Charlie5DH/Flip-Disc-Display/Documentation/Diagrama de flujo.png

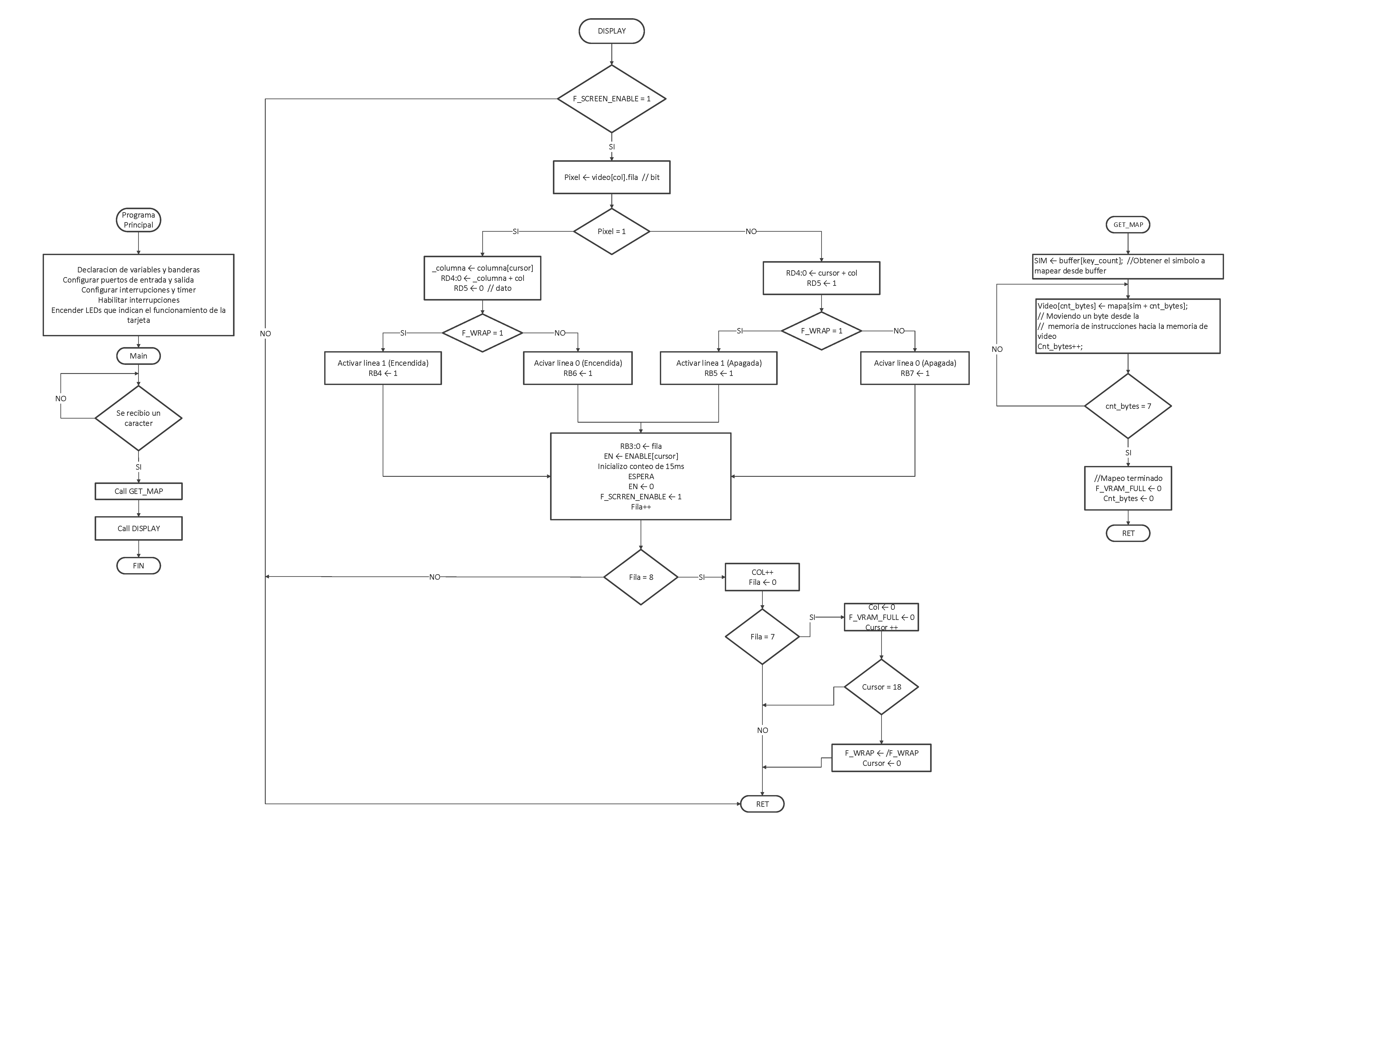
Documentation/Diagrama de flujo.png
