Charlie5DH/Flip-Disc-Display/Documentation/unidad de procesamiento.pdf

# UNIDAD DE PROCESAMIENTO

X1

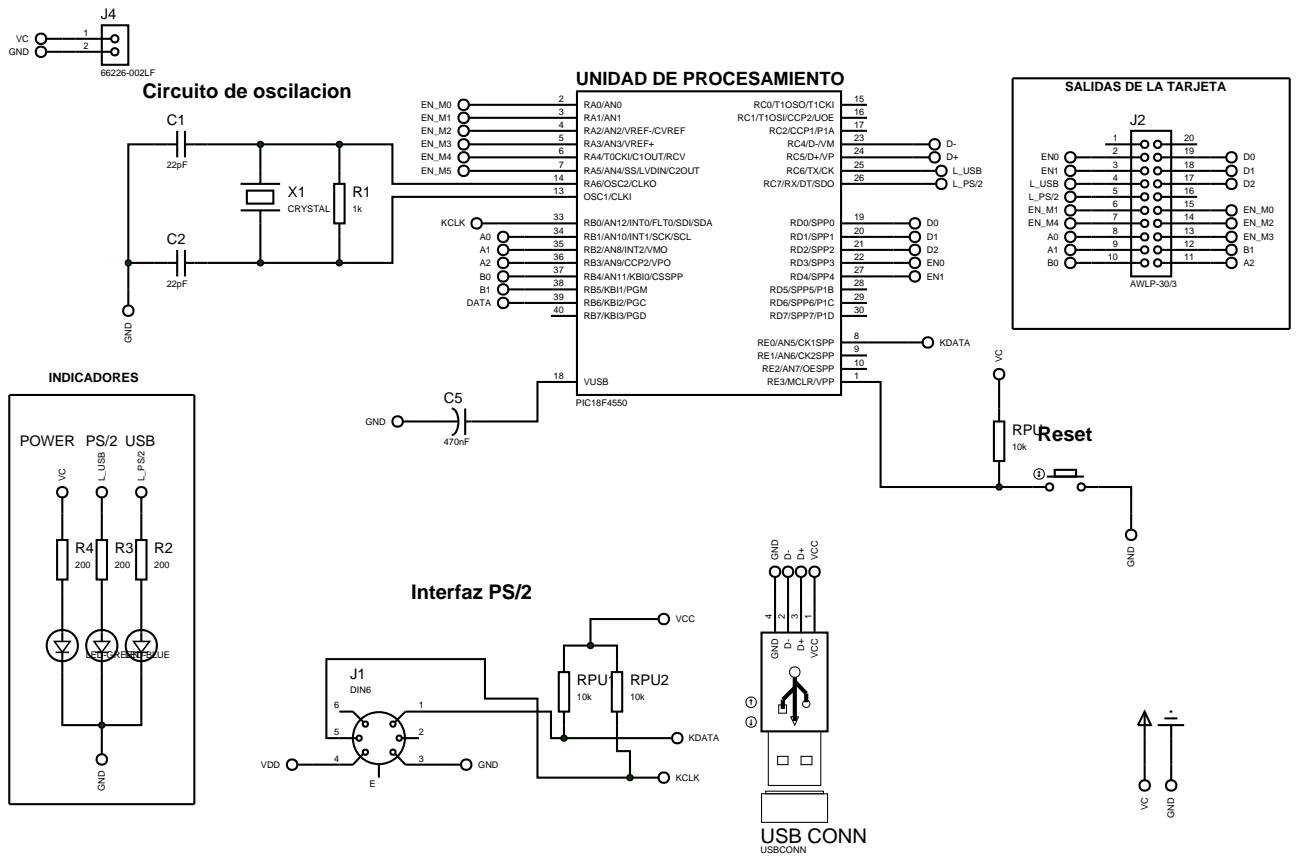
[picture p18: page 1]

SALIDAS DE LA TARJETA

USB CONN USBCONN GND D⁻ D⁺VCC
