Charlie5DH/Flip-Disc-Display/Simulation/simulacion.pdf

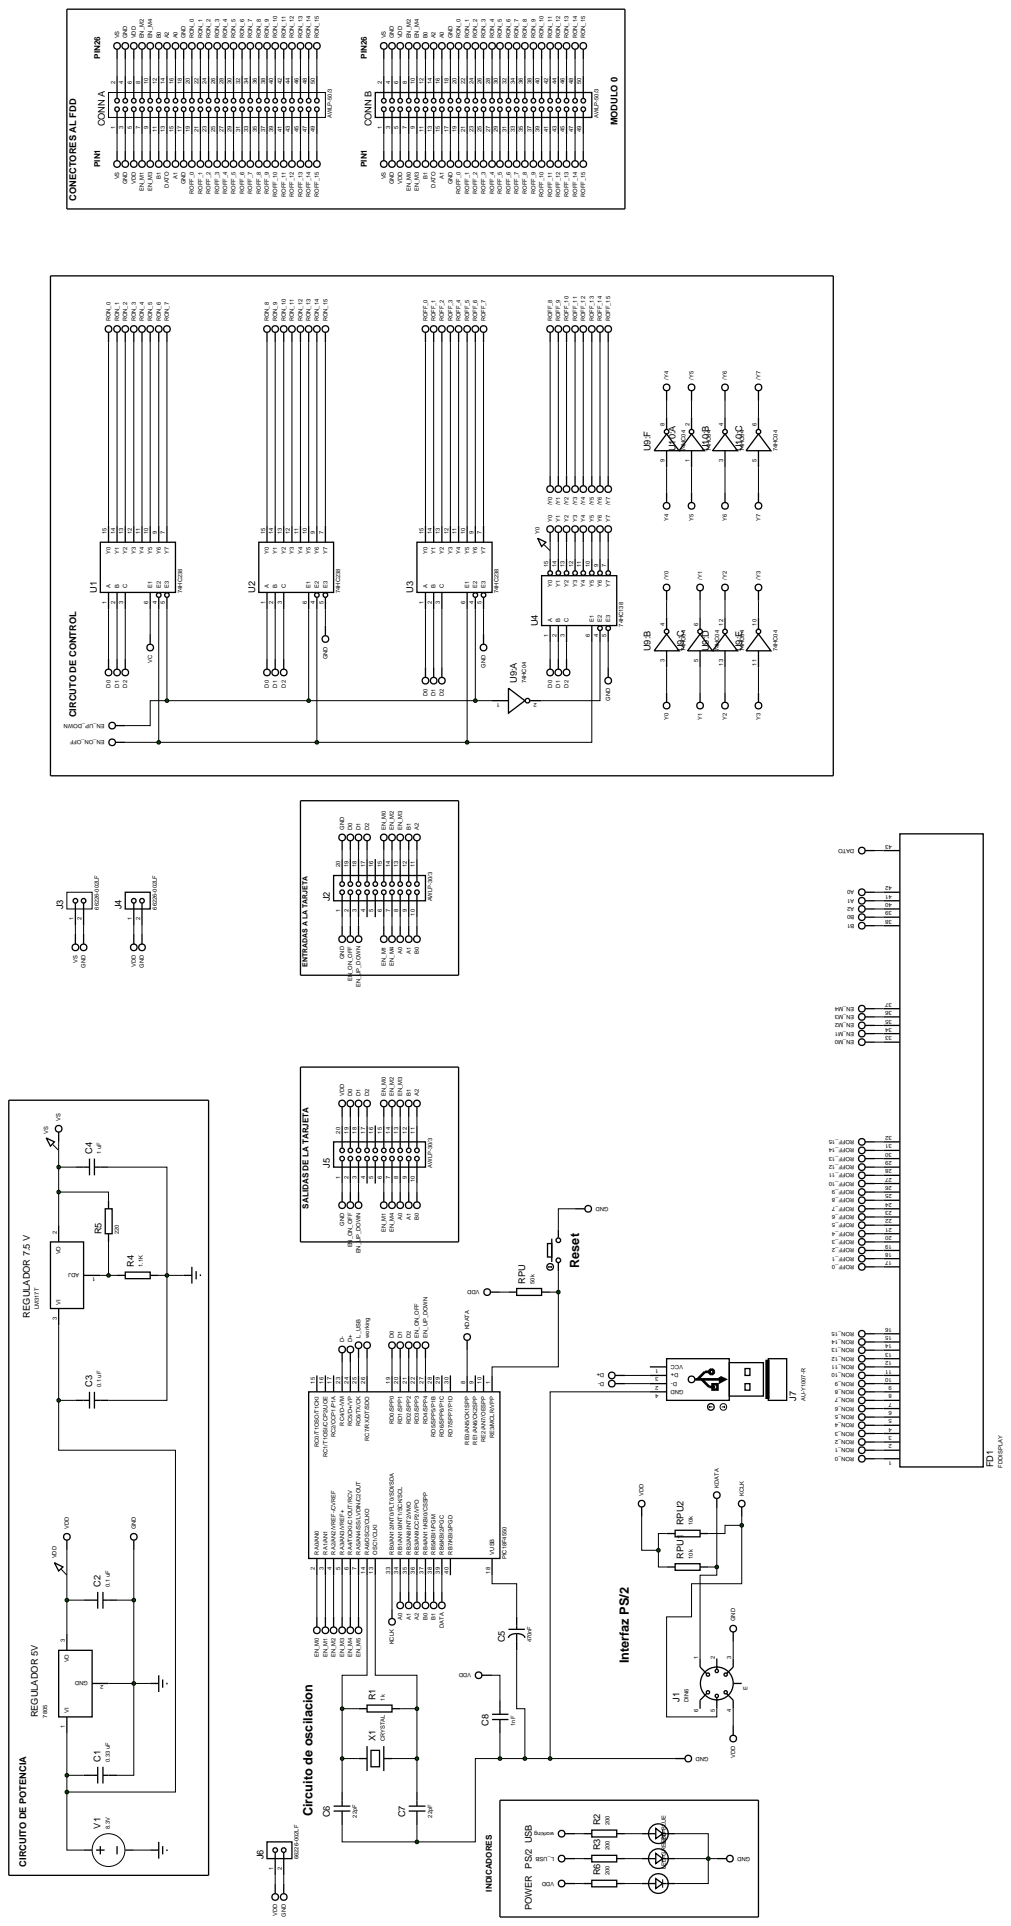
[picture p19: page 1]

CONECTORES AL FDD CIRCUTO DE CONTROL

GND GND VDD GND

SALIDAS DE LA TARJETA
