Charlie5DH/Flip-Disc-Display/Documentation/Diagrama de flujo.pdf

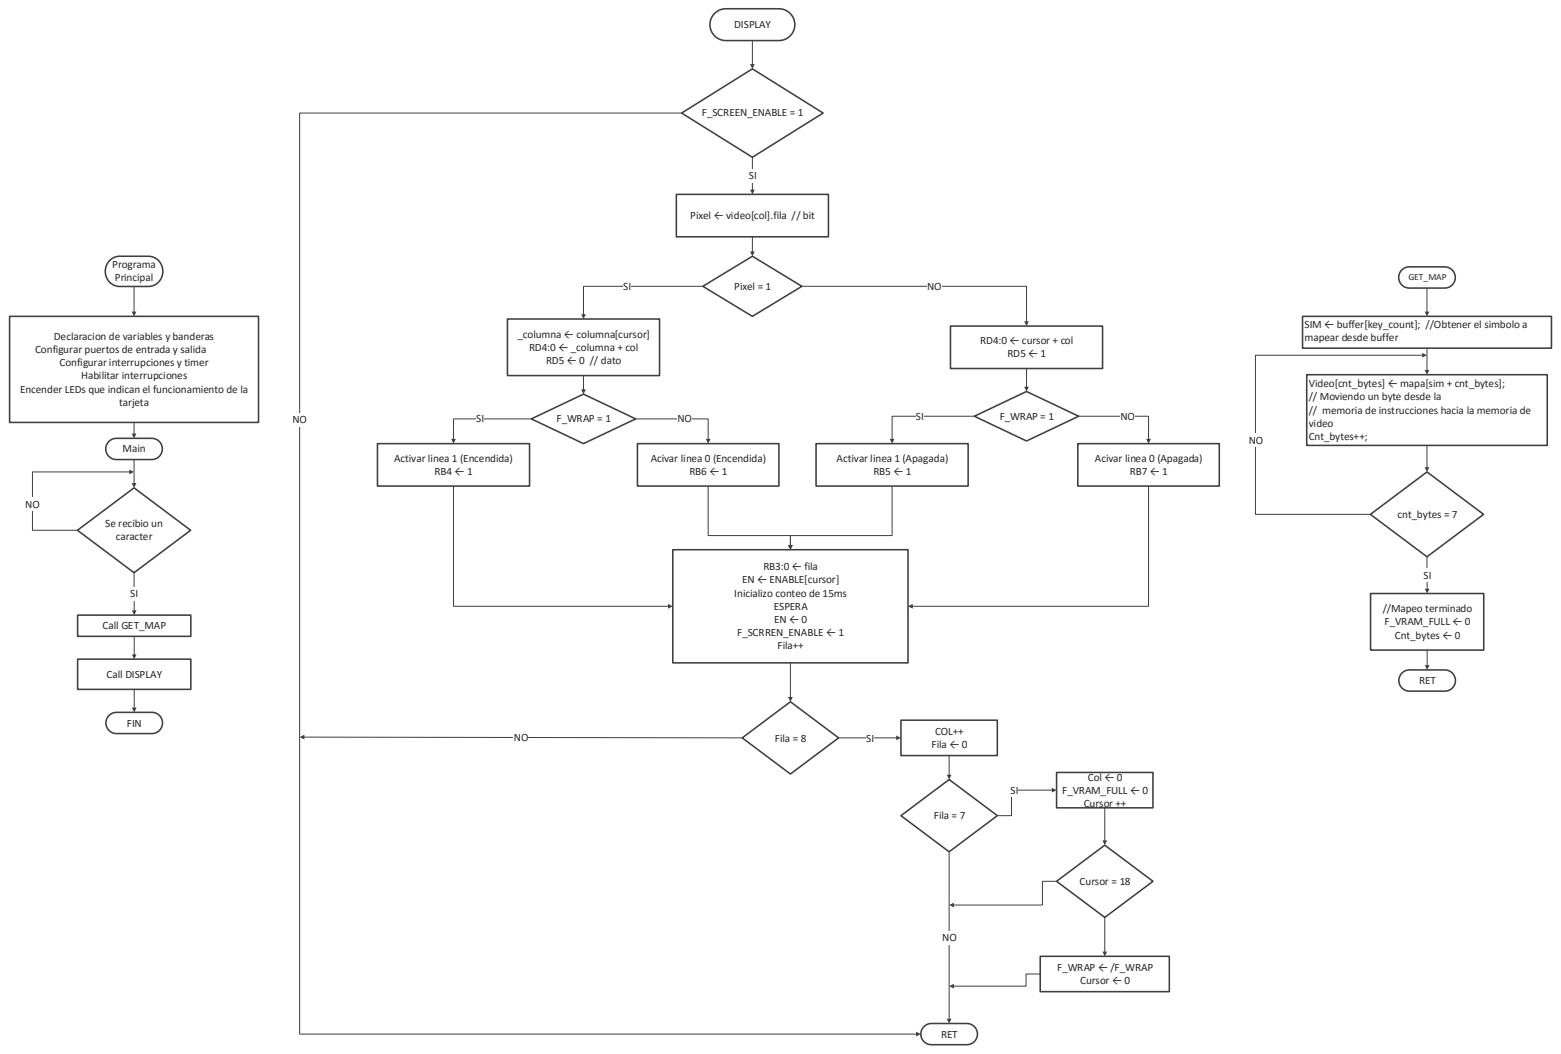
[picture p20: page 1]
GET_MAP; cnt_bytes = 7; SIM; buffer[key_count]; //Obtener el simbolo a; //Mapeo terminado F_VRAM_FULL Cnt_bytes; RET; DISPLAY; F_SCREEN_ENABLE = 1; Pixel; video[col].fila // bit; Pixel = 1; _columna; columna[cursor]; _columna + col; dato; cursor + col; F_WRAP = 1; fila; ENABLE[cursor]; ESPERA EN F_SCRREN_ENABLE Fila++; Fila = 8; COL++ Fila; Fila = 7; Col F_VRAM_FULL Cursor ++; Cursor = 18; F_WRAP; /F_WRAP; Cursor; Programa Principal; tarjeta; Call GET_MAP; FIN; Main; Call DISPLAY

mapear desde buffer

Declaracion de variables y banderas
Configurar puertos de entrada y salida
Configurar interrupciones y timer
Habilitar interrupciones

Video[cnt_bytes] mapa[sim + cnt_bytes]; // Moviendo un byte desde la // memoria de instrucciones hacia la memoria de video Cnt_bytes++;

Encender LEDs que indican el funcionamiento de la

Activar linea 1 (Encendida)

Acivar linea 0 (Encendida)

Activar linea 1 (Apagada)

Acivar linea 0 (Apagada)

Se recibio un
caracter

Inicializo conteo de 15ms
