Charlie5DH/Flip-Disc-Display/Documentation/PCB_micro.pdf

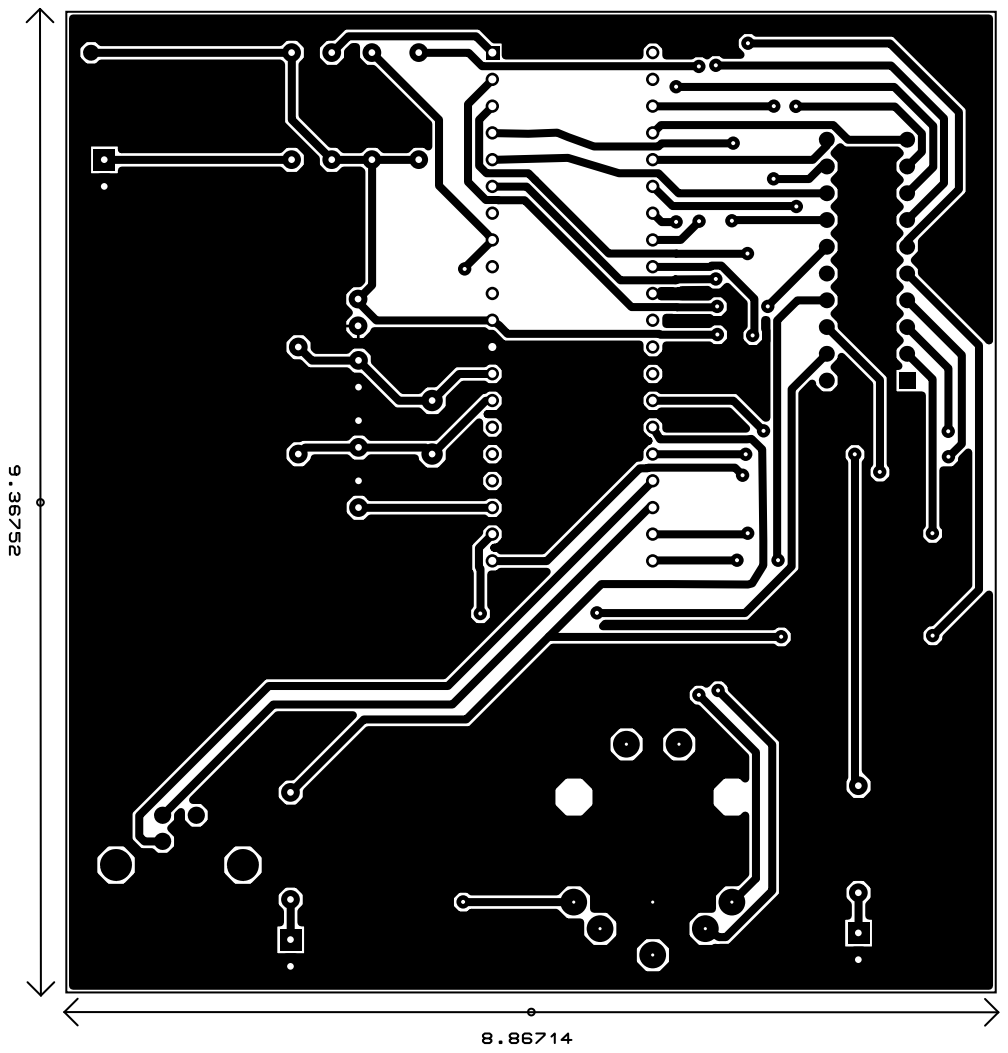
[picture p21: page 1]
