Charlie5DH/Flip-Disc-Display/Documentation/PCB_micro_top_coper.pdf

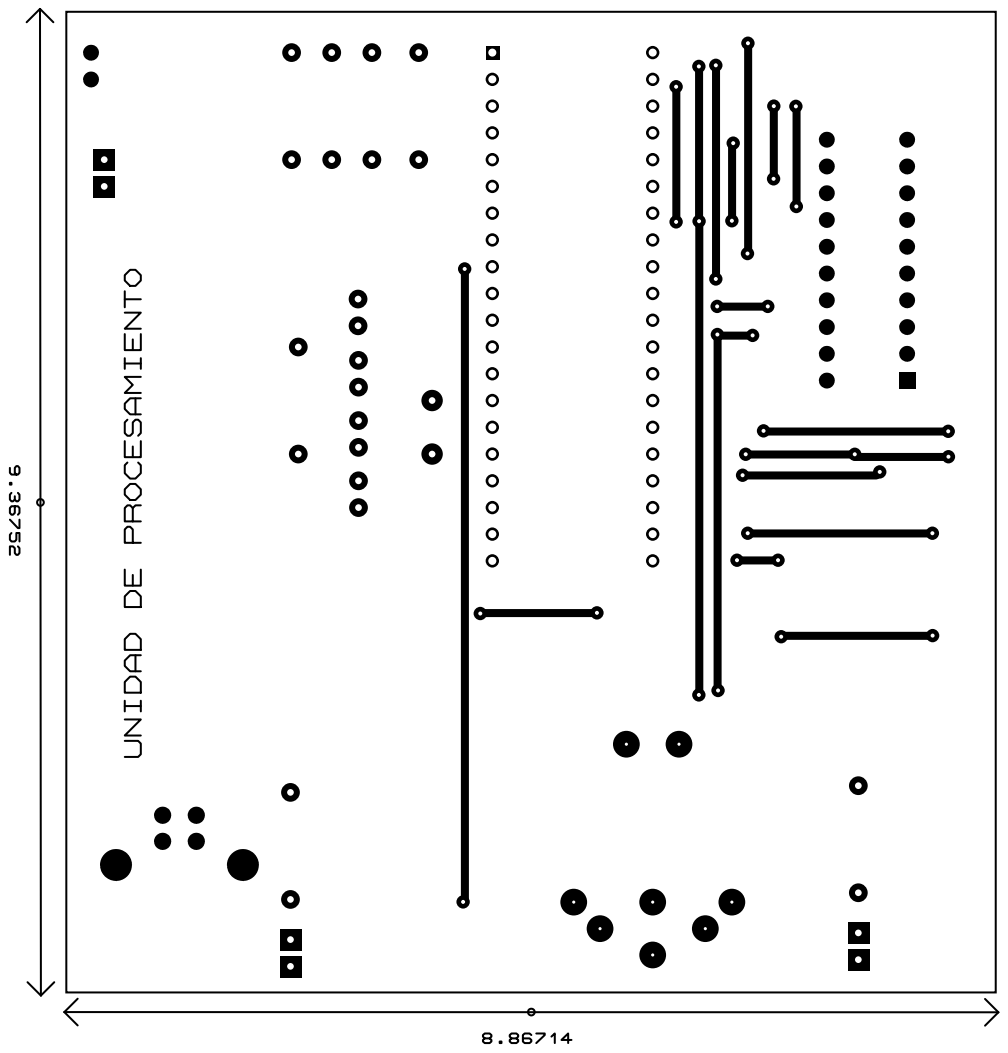
[picture p22: page 1]
