Charlie5DH/Flip-Disc-Display/Documentation/PCB_silk.pdf

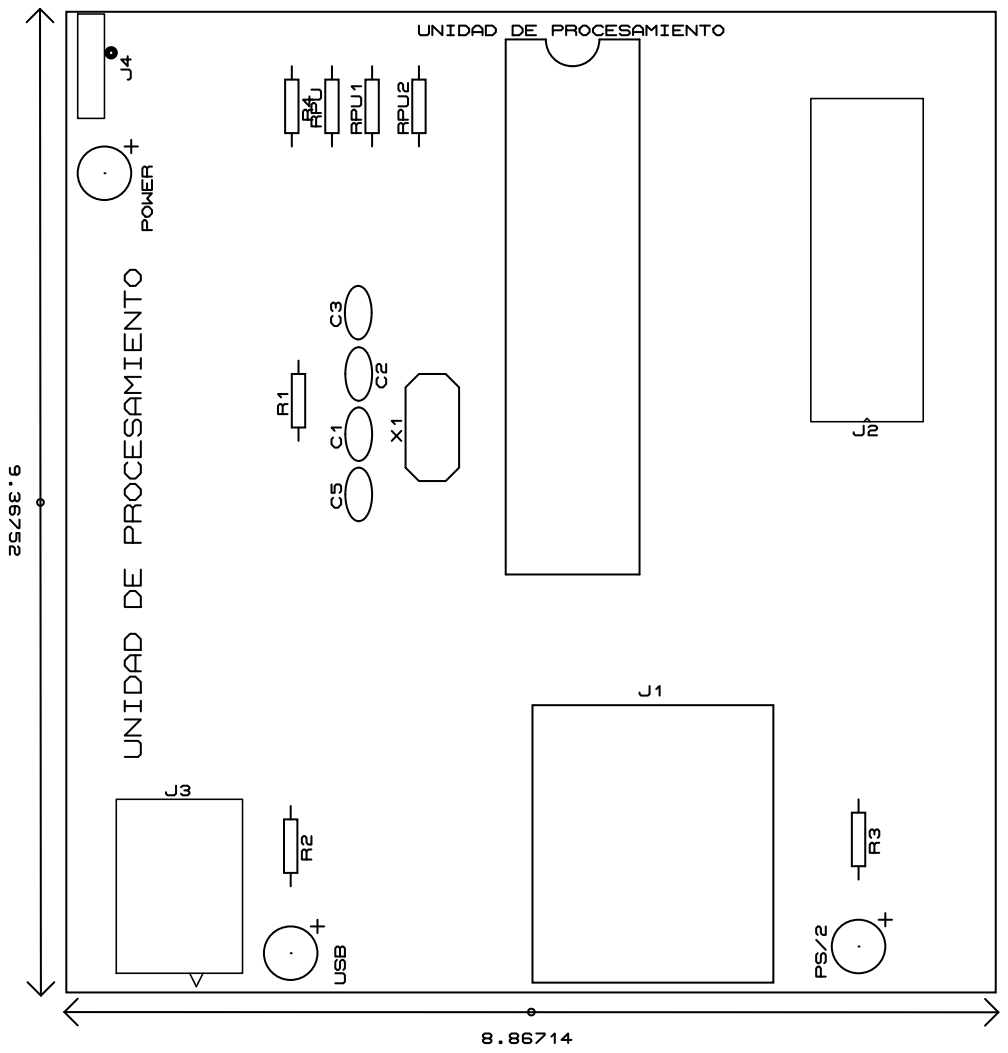
[picture p23: page 1]
