Charlie5DH/Flip-Disc-Display/Documentation/tajeta_de_control_2.1.pdf

## CONN A

U1

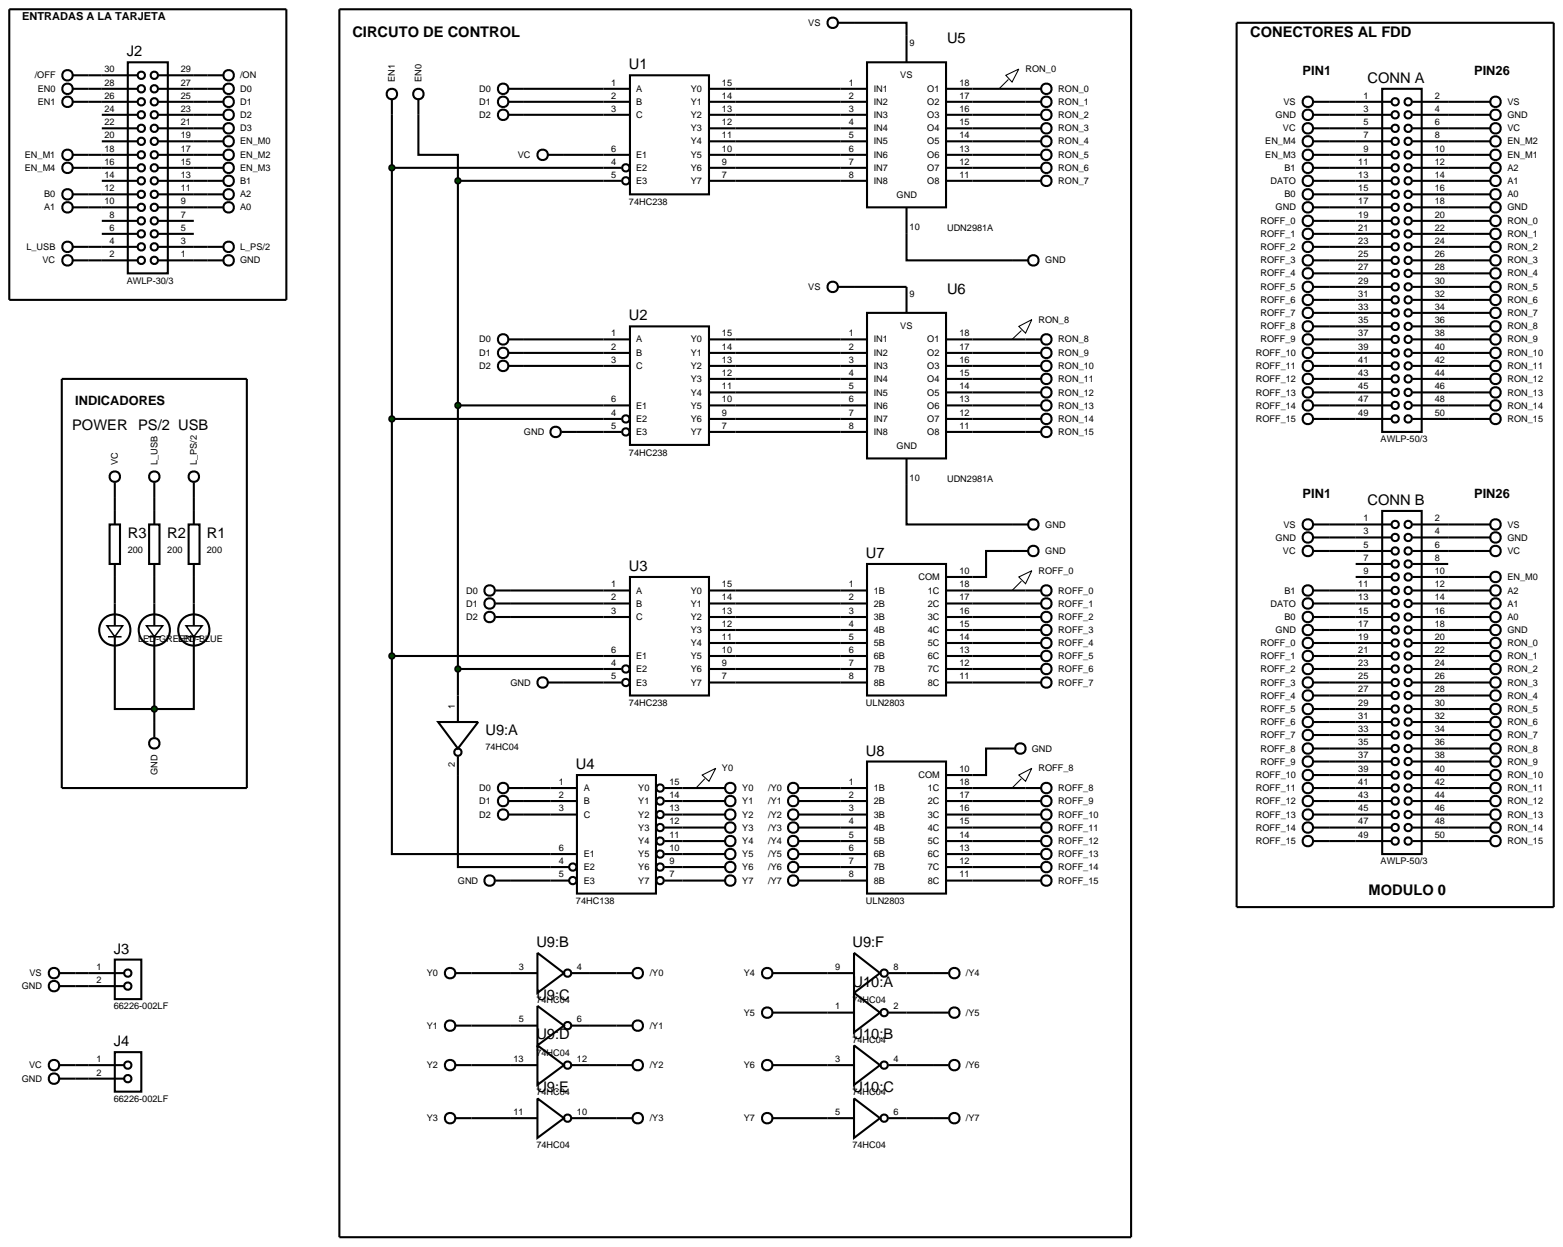
[picture p24: page 1]
