Charlie5DH/Flip-Disc-Display/Documentation/tajeta_de_control_2.pdf

## CONN A

U1

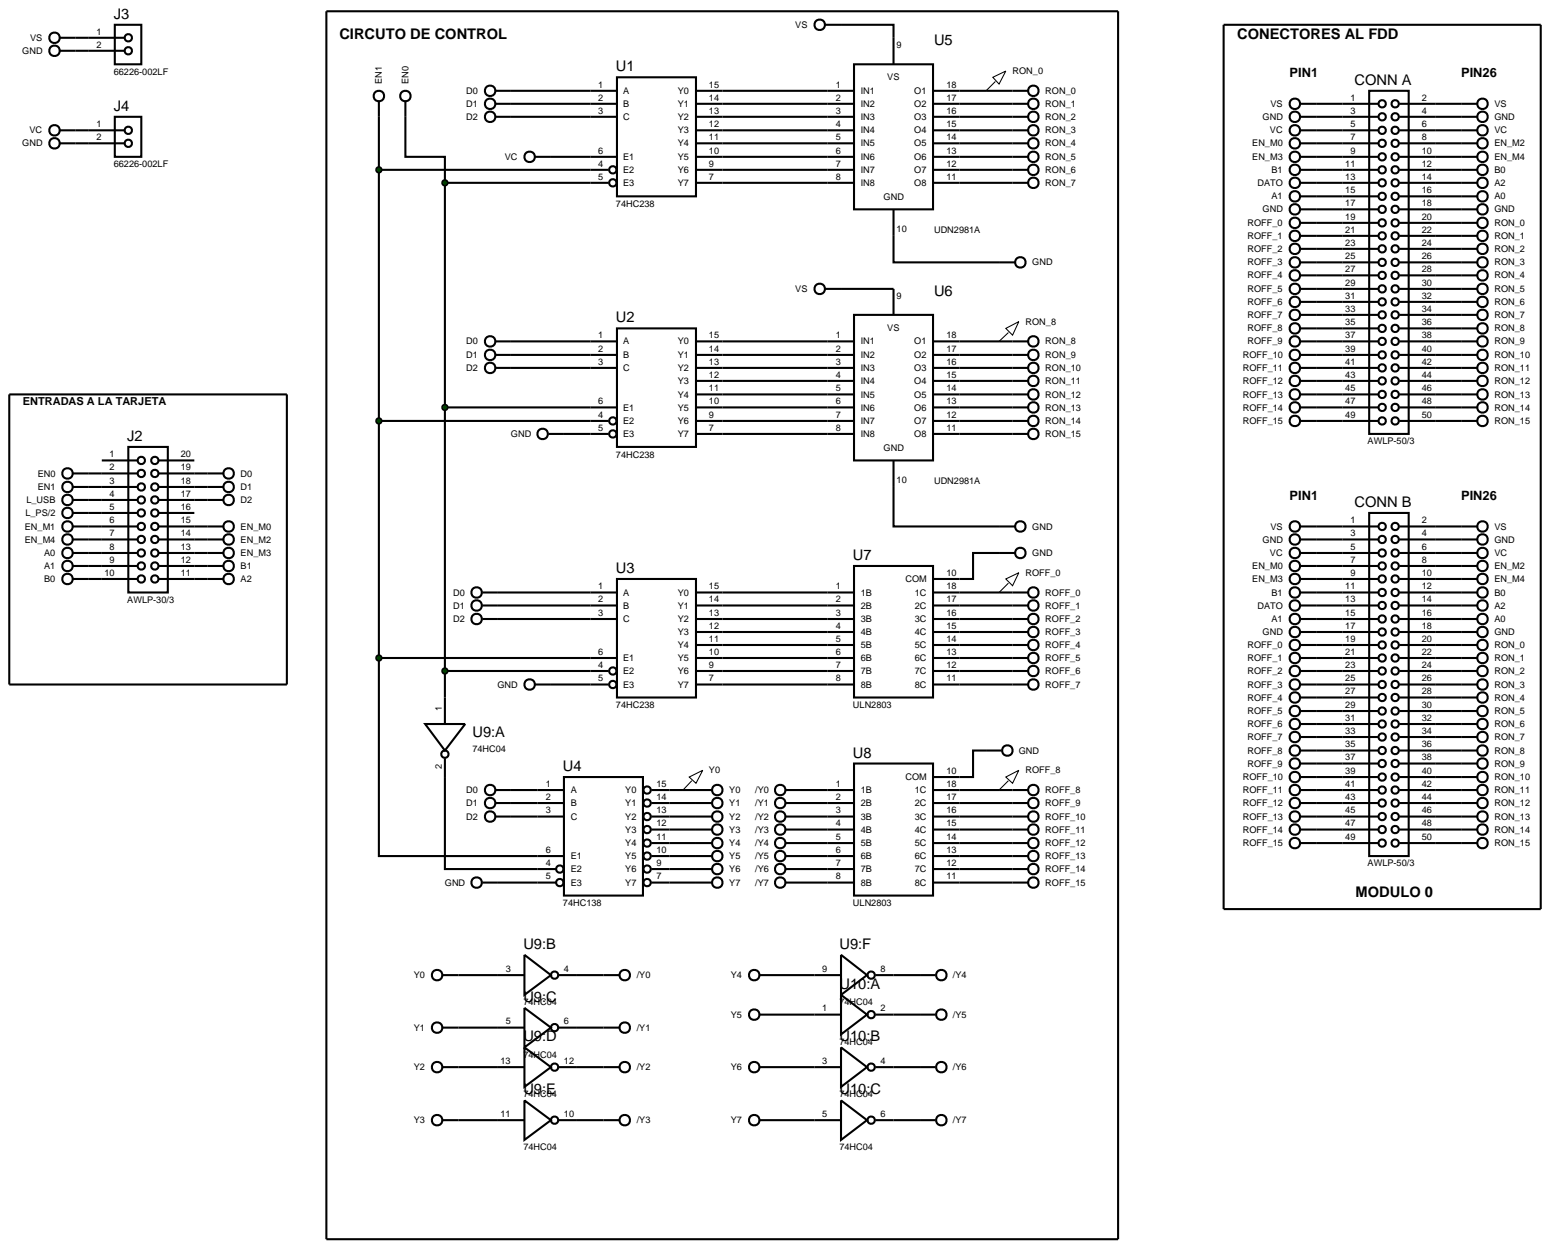
[picture p25: page 1]
