Charlie5DH/Flip-Disc-Display/Simulation/Flip-disc display.PDF

U2

# CONTROLADOR DE FILAS

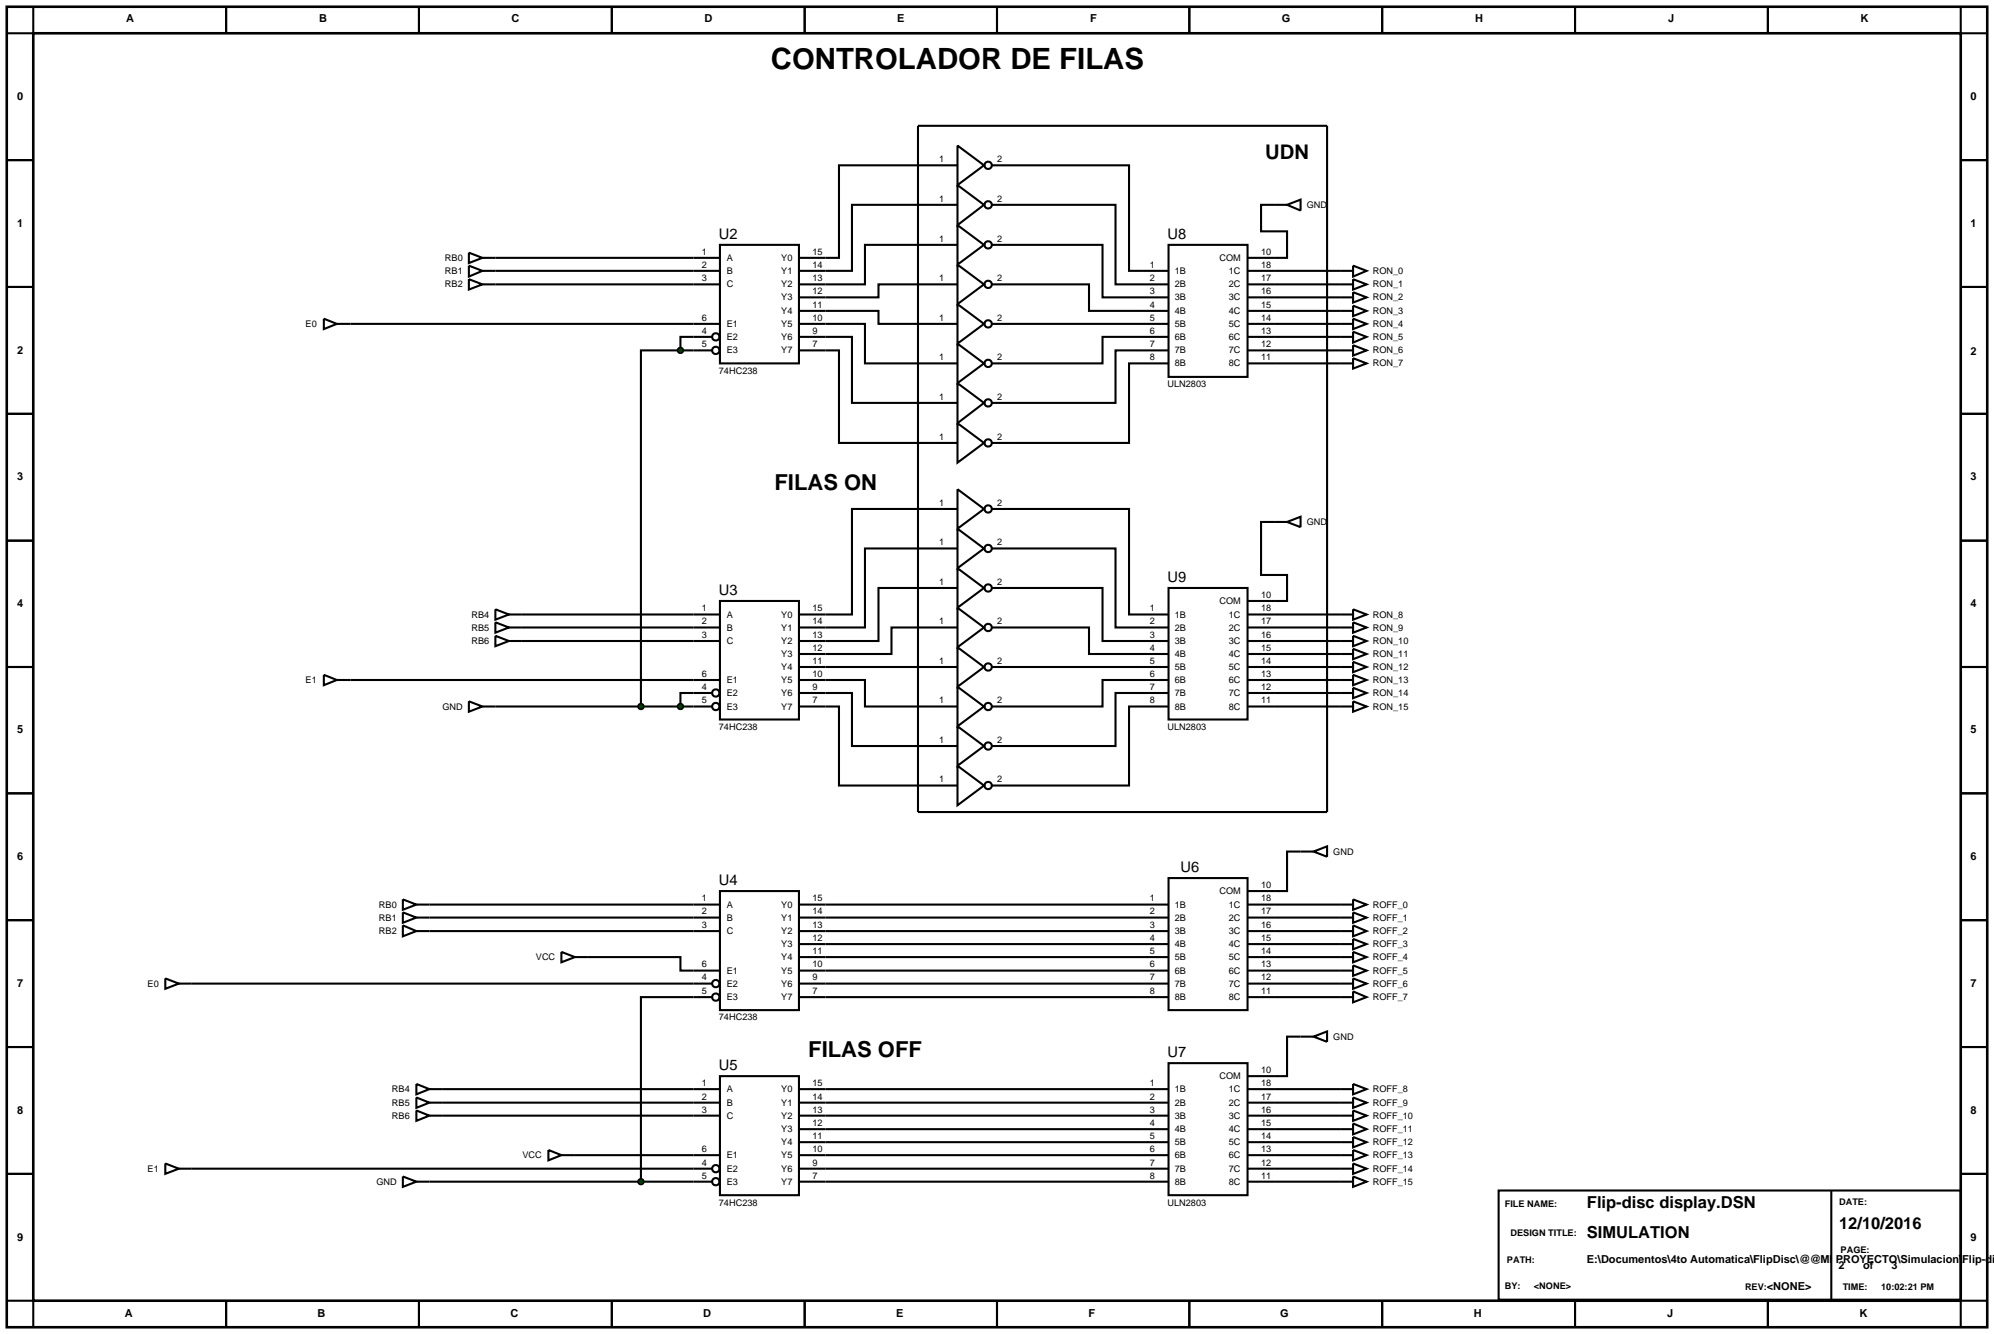
[picture p26: page 1]
FILE NAME:; DATE:; PAGE:; <NONE>; PATH:; E:\Documentos\4to Automatica\FlipDisc\@@MI PROYECTO\Simulacion\Flip-disc display.DSN 2; REV:<NONE>; TIME:; FILAS ON; FILAS OFF; GND; COM; ULN2803; ROFF_0 ROFF_1 ROFF_2 ROFF_3 ROFF_4 ROFF_5 ROFF_6 ROFF_7; ROFF_8 ROFF_9 ROFF_10 ROFF_11 ROFF_12 ROFF_13 ROFF_14 ROFF_15; RON_0 RON_1 RON_2 RON_3 RON_4 RON_5 RON_6 RON_7; RON_8 RON_9 RON_10 RON_11 RON_12 RON_13 RON_14 RON_15; UDN; VCC

Flip-disc display.DSN

DESIGN TITLE: SIMULATION
