Charlie5DH/Flip-Disc-Display/Simulation/simulacion2.pdf

## CONN A

U1

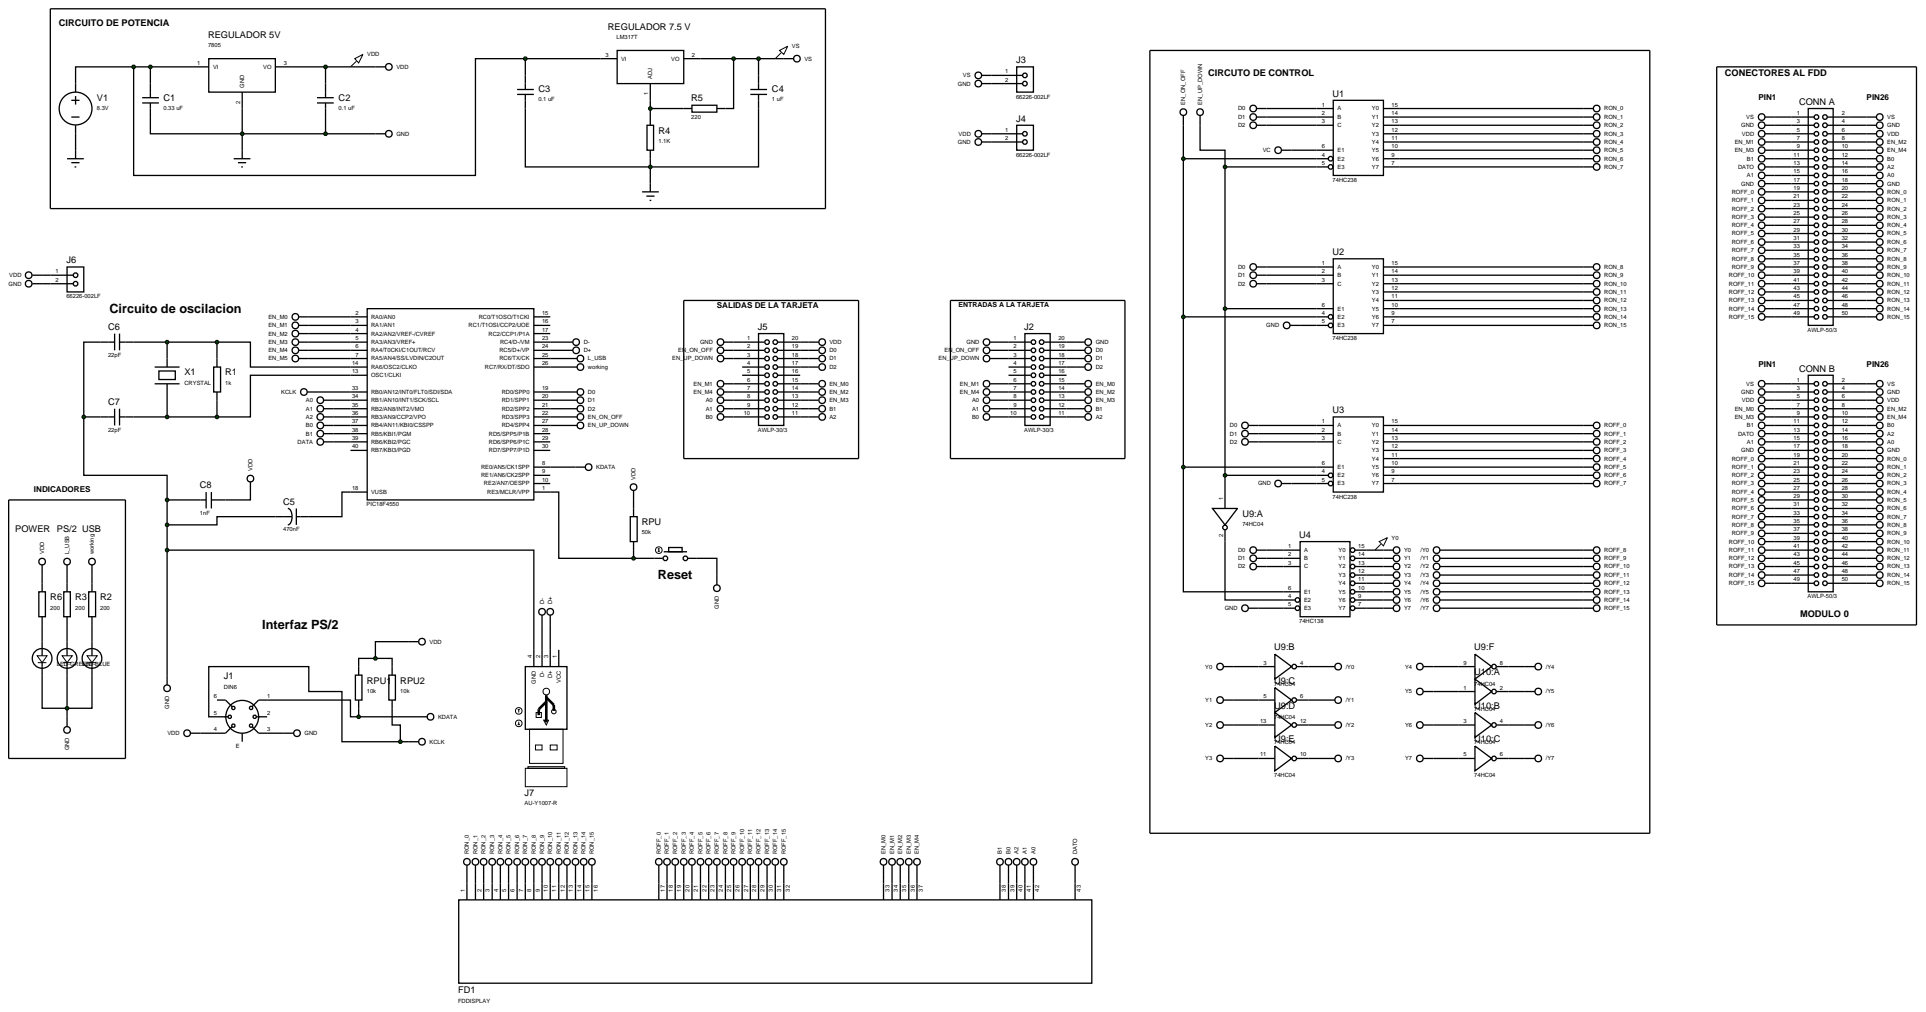
[picture p27: page 1]

SALIDAS DE LA TARJETA
