Charlie5DH/Flip-Disc-Display/Boards/CIRCUITO DE POTENCIA/Circuito de potencia.PDF

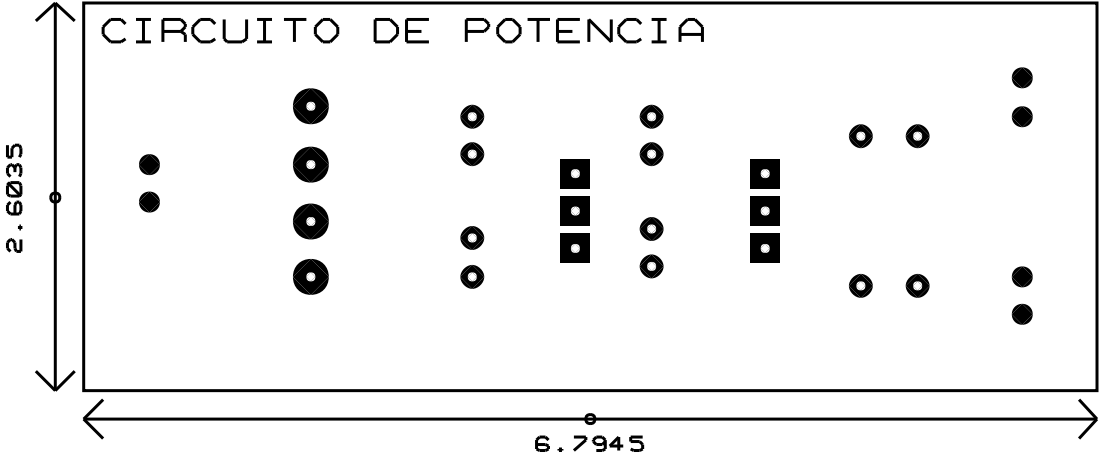
[picture p28: page 1]
