Charlie5DH/Flip-Disc-Display/Boards/CON UN SOLO PUERTO_ULTIMA/Tarjeta de control_Funcional_CABLEADA_ULTIMA.pdf

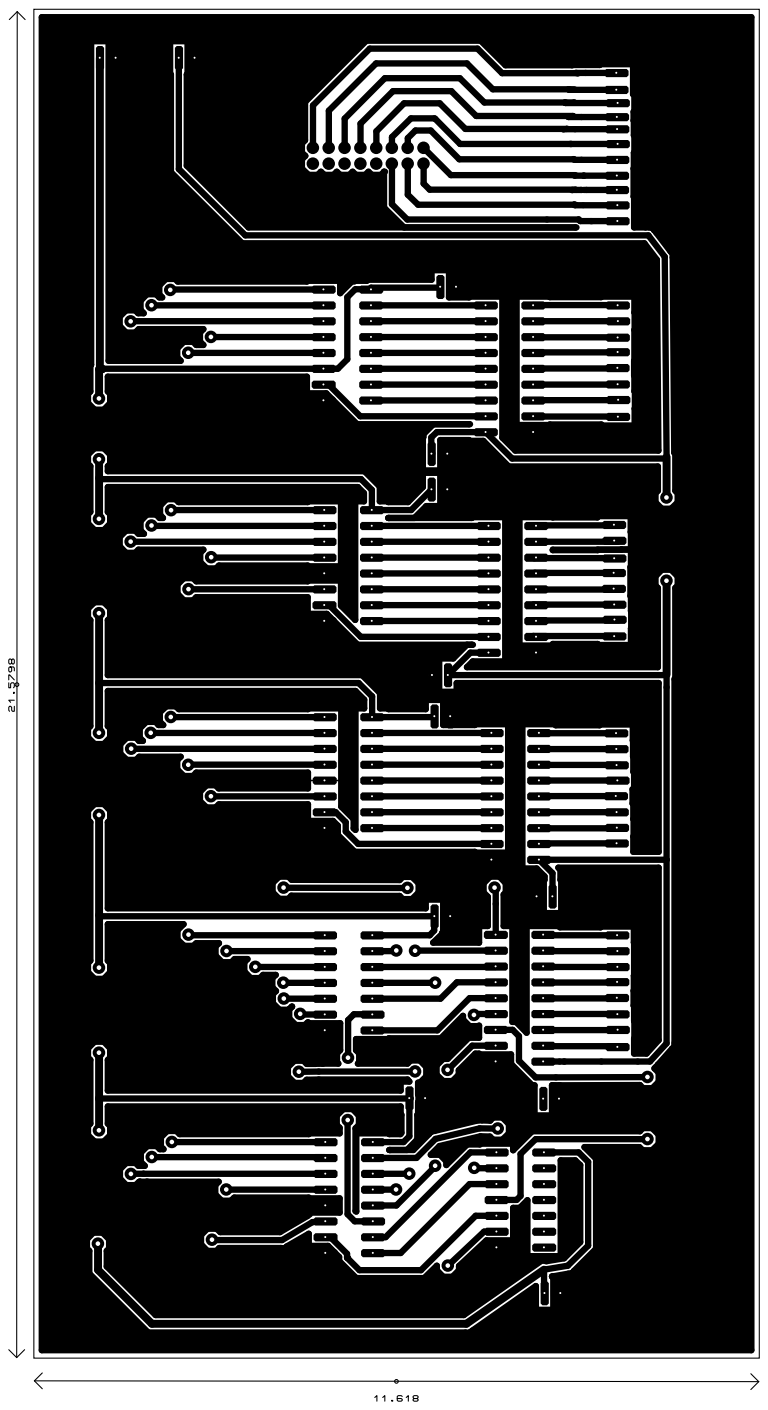
[picture p29: page 1]
