Charlie5DH/Flip-Disc-Display/Boards/CON UN SOLO PUERTO_ULTIMA/Tarjeta de control_Funcional_CABLEADA_ULTIMA_MIRROR.pdf

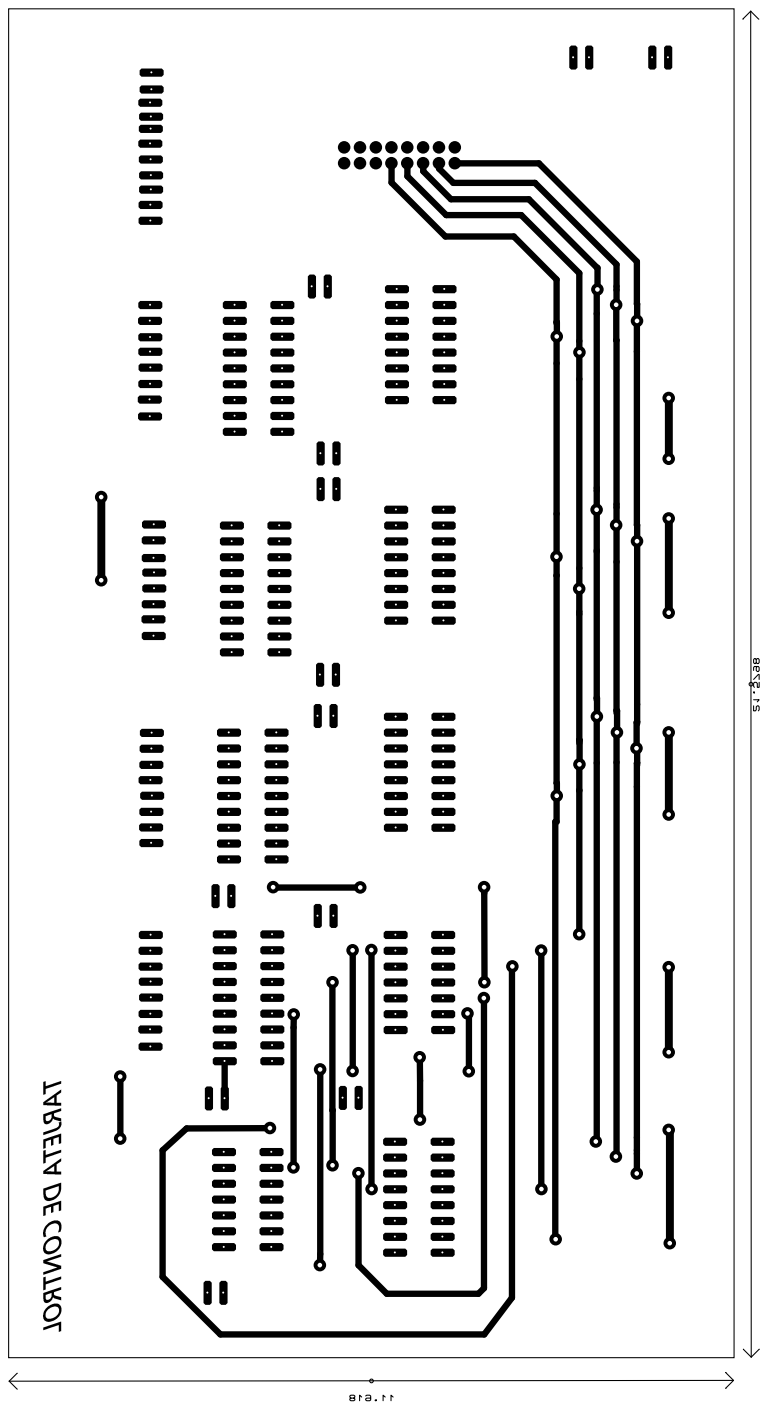
[picture p30: page 1]
