Charlie5DH/Flip-Disc-Display/Boards/CONECTOR/CONECTOR_50_PINES.pdf

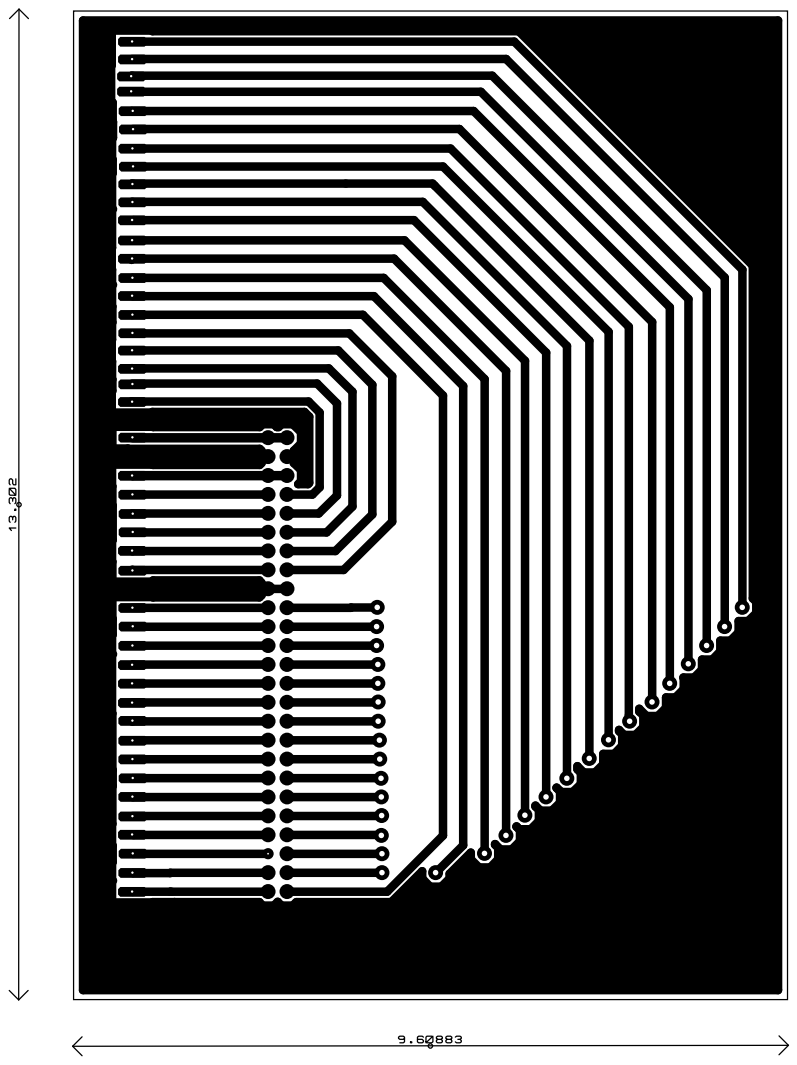
[picture p31: page 1]
