Charlie5DH/Flip-Disc-Display/Boards/CONECTOR/CONECTOR_50_PINES_MIRROR.pdf

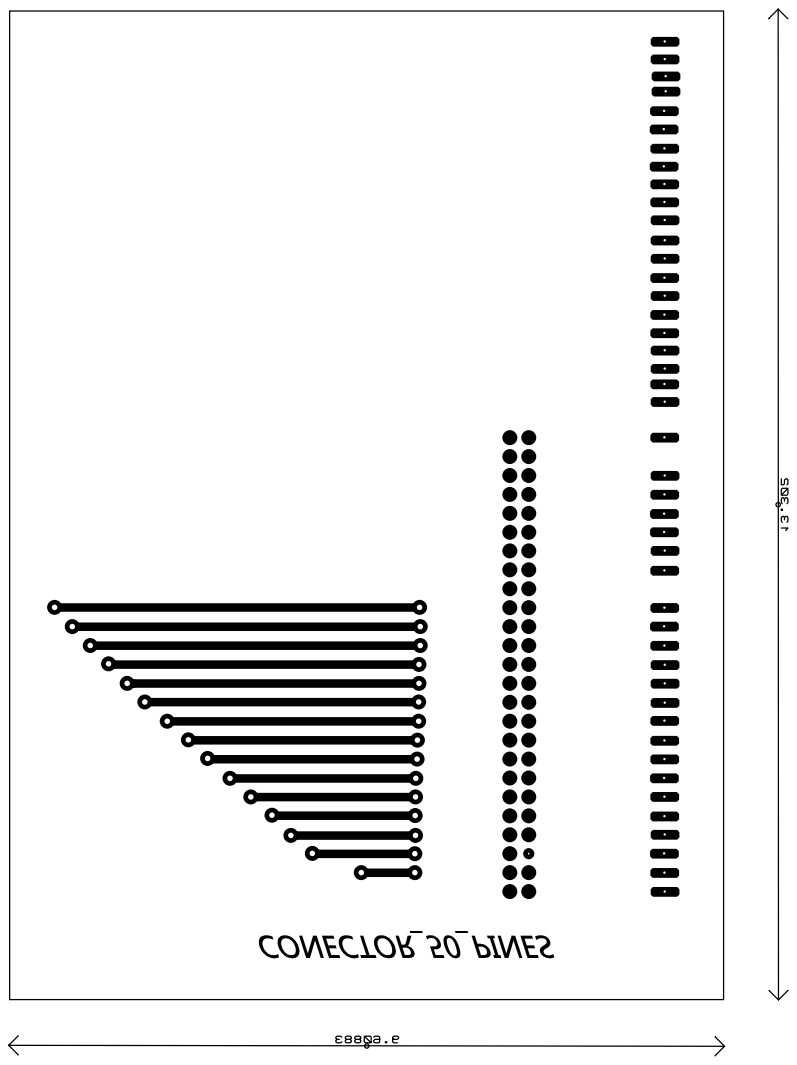
[picture p32: page 1]
