Charlie5DH/Flip-Disc-Display/(list of files, drawings)

Other design files:
Boards/CIRCUITO DE POTENCIA/Circuito de potencia.pdsprj
Boards/CON UN SOLO PUERTO/Tarjeta de control_Funcional_CABLEADA.pdsprj
Boards/CON UN SOLO PUERTO_ULTIMA/Tarjeta de control_Funcional_CABLEADA.pdsprj
Boards/CONECTOR/Tarjeta de control_Funcional_CABLEADA.pdsprj
Boards/UNIDAD DE MICROPROCESAMIENTO/Unidad de microprocesamiento2.pdsprj
Boards/UNIDAD DE MICROPROCESAMIENTO/Unidad de microprocesamiento.pdsprj
Boards_for_machine/CIRCUITO DE POTENCIA/Circuito de potencia.pdsprj
Boards_for_machine/CON UN SOLO PUERTO_ULTIMA/Tarjeta de control_Funcional_CABLEADA.pdsprj
Boards_for_machine/UNIDAD DE MICROPROCESAMIENTO/Unidad de microprocesamiento.pdsprj
Simulation/Circuito de potencia.pdsprj
Simulation/Controlador_columnas_funcional.DSN
Simulation/Flip-disc display2.DSN
Simulation/Flip-disc display.DSN
Simulation/Flip-disc display.pdsprj
Simulation/Flip-disc PRIMERO.pdsprj
Simulation/Tarjeta de control.pdsprj
Simulation/Tarjeta de control_2.pdsprj
Simulation/Testing proces.pdsprj
Simulation/Unidad de microprocesamiento.pdsprj
