Charlie5DH/Flip-Disc-Display/(commit log)

2020-07-24 Files for the firmware
    [MyProject.cfg]
2020-07-24 Files for another version of the firmware
    [MyProject.cfg]
2020-07-24 Boards to make by hand
    [Circuito de potencia.pdsprj, Tarjeta de control_Funcional_CABLEADA.pdsprj, Unidad de microprocesamiento.pdsprj, Unidad de microprocesamiento2.pdsprj]
2020-07-24 Boards for machine
    [Circuito de potencia.pdsprj, Tarjeta de control_Funcional_CABLEADA.pdsprj, Unidad de microprocesamiento.pdsprj]
2020-07-24 Program to run in the arduino
2020-07-24 Simulations of the circuit made in Proteus
    [Circuito de potencia.pdsprj, Controlador_columnas_funcional.DSN, Flip-disc PRIMERO.pdsprj, Flip-disc display.DSN, Flip-disc display.pdsprj, Flip-disc display2.DSN, Tarjeta de control.pdsprj, Tarjeta de control_2.pdsprj]
2020-07-24 Different tests in arduino
2020-07-24 Project description, boards pcb, visual interface, etc.
2020-07-24 Other arduino testing softwares
